vglarra/jaiba-monitor-support-frame/mon2_11in6_v21_m4ends_base.stl

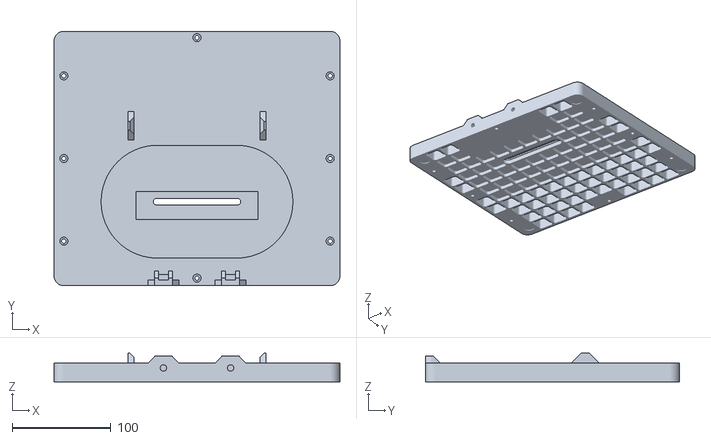
[picture p1: CAD file, 2026-11-12]
mon2_11in6_v21_m4ends_base.stl
290.0 x 258.0 x 29.0
