vglarra/jaiba-monitor-support-frame/mon1_7in_v19_leftrib_beside_turntable.stl

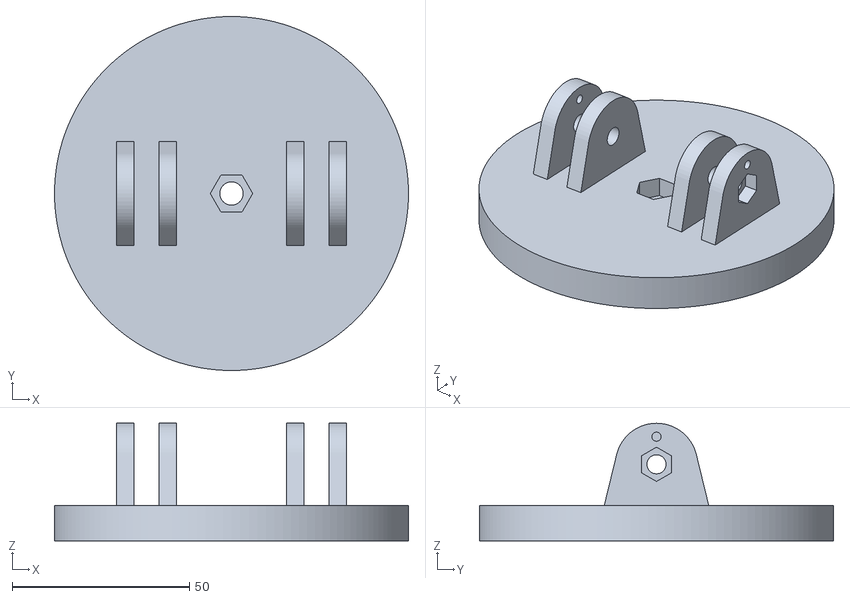
[picture p2: CAD file, 2026-11-08]
mon1_7in_v19_leftrib_beside_turntable.stl
100.0 x 100.0 x 33.2
