vglarra/jaiba-monitor-support-frame/mon1_7in_v19_leftrib_beside_lid.stl

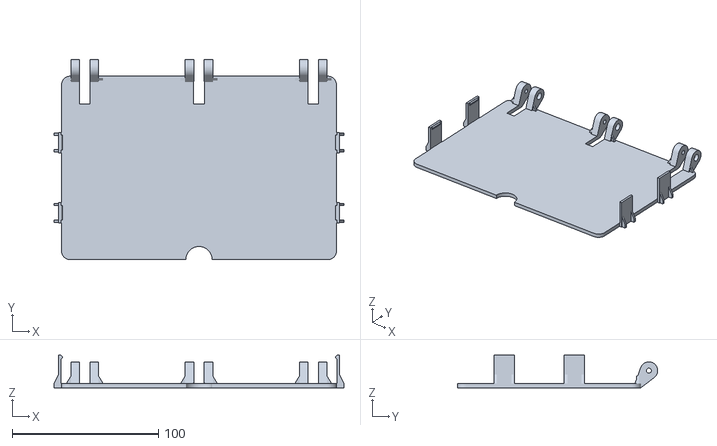
[picture p3: CAD file, 2026-11-08]
mon1_7in_v19_leftrib_beside_lid.stl
198.0 x 136.8 x 22.2
