vglarra/jaiba-monitor-support-frame/mon1_7in_v19_leftrib_beside_frame.stl

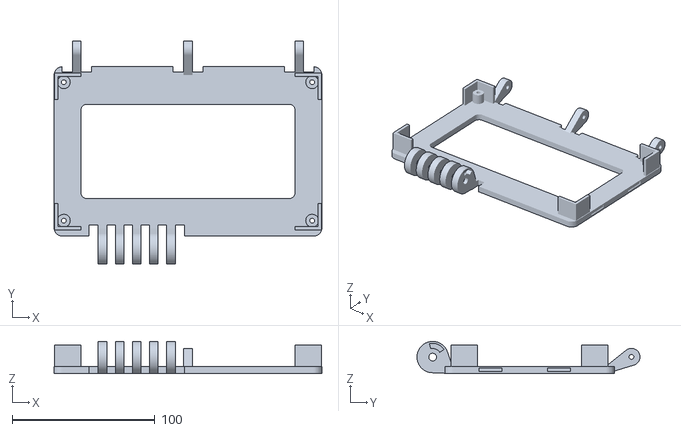
[picture p4: CAD file, 2026-11-08]
mon1_7in_v19_leftrib_beside_frame.stl
187.8 x 156.3 x 22.6
