vglarra/jaiba-monitor-support-frame/mon1_7in_v19_leftrib_beside_base.stl

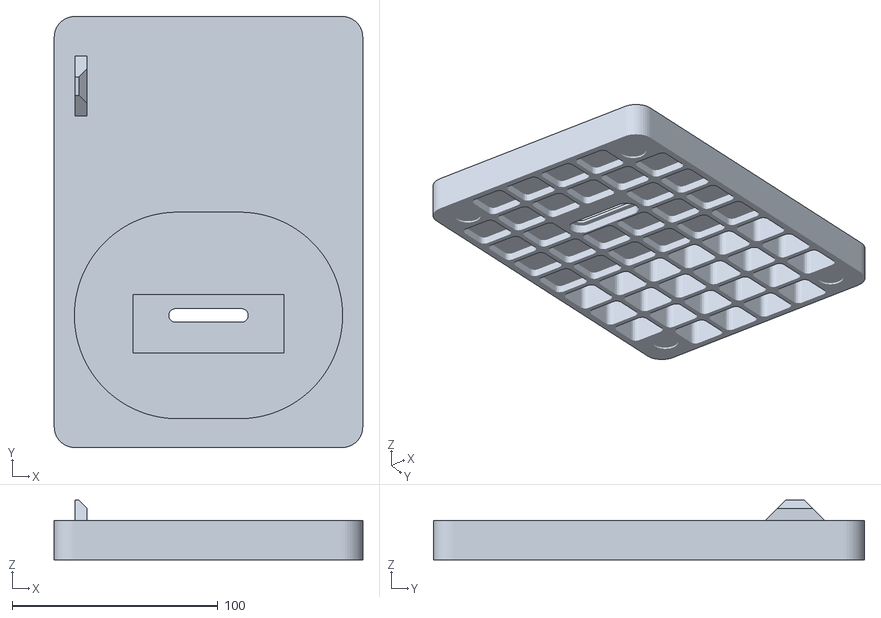
[picture p5: CAD file, 2026-11-08]
mon1_7in_v19_leftrib_beside_base.stl
150.0 x 209.5 x 29.0
