vglarra/jaiba-monitor-support-frame/mon1_7in_v19_leftrib_beside_spacer.stl

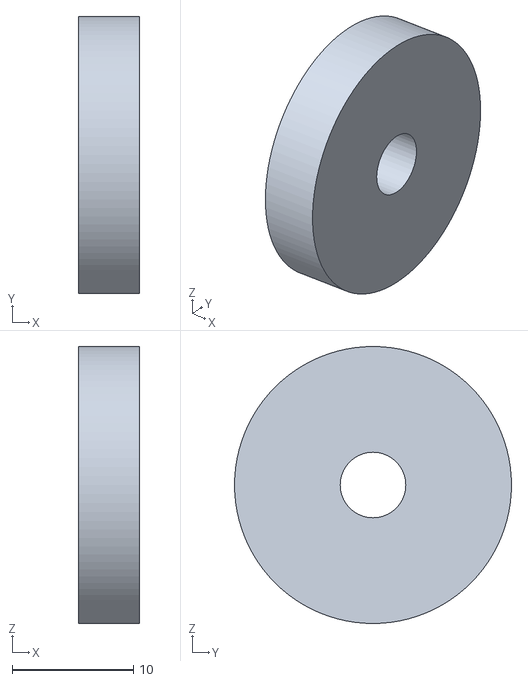
[picture p6: CAD file, 2026-11-08]
mon1_7in_v19_leftrib_beside_spacer.stl
5.00 x 22.8 x 22.8
