vglarra/jaiba-monitor-support-frame/mon1_7in_v19_leftrib_beside_carriage.stl

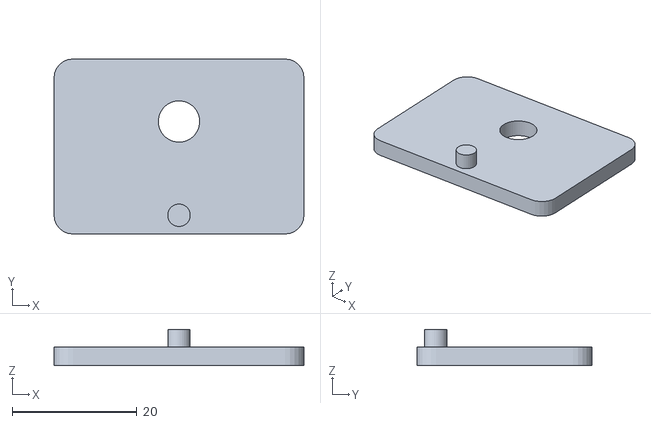
[picture p7: CAD file, 2026-11-08]
mon1_7in_v19_leftrib_beside_carriage.stl
40.0 x 28.0 x 5.80
