vglarra/jaiba-monitor-support-frame/(list of files, cad)

Other CAD files:
mon1_7in_v19_leftrib_beside_assembly.blend
mon2_11in6_v21_m4ends_assembly.blend
