vglarra/jaiba-monitor-support-frame/(commit log)

2026-11-08 Initial commit: parametric monitor stand generator and STL variants
    Add Blender scripts for the 7in PCB-monitor stand (make_stand.py) and 11.6in VESA monitor stand (make_stand_mon2.py, and the spacer variant). Include export STLs and assembly .blend files for v14, v15 and v16 designs, plus README.
    [mon2_11in6_v14_m6swivel_assembly.blend, mon2_11in6_v14_m6swivel_base.stl, mon2_11in6_v14_m6swivel_carriage.stl, mon2_11in6_v14_m6swivel_frame.stl, mon2_11in6_v14_m6swivel_lockblock.stl, mon2_11in6_v14_m6swivel_turntable.stl, mon2_11in6_v15_spacer_assembly.blend, mon2_11in6_v15_spacer_base.stl]
2026-11-08 Keep only the latest design of each stand; drop old versions
    Remove mon2 v14/v15/v16 outputs and mon1 v15-v18 outputs. Keep mon1 v19 (leftrib_beside) via make_stand.py and mon2 v18 (seatribs) via make_stand_mon2.py. Remove the duplicated 'make_stand_mon2 (1).py' copy.
    [mon1_7in_v19_leftrib_beside_assembly.blend, mon1_7in_v19_leftrib_beside_base.stl, mon1_7in_v19_leftrib_beside_carriage.stl, mon1_7in_v19_leftrib_beside_frame.stl, mon1_7in_v19_leftrib_beside_lid.stl, mon1_7in_v19_leftrib_beside_spacer.stl, mon1_7in_v19_leftrib_beside_turntable.stl, mon2_11in6_v14_m6swivel_assembly.blend]
2026-11-12 Bump mon2 to v21 (m4ends); drop v18-v20 outputs
    Keep only the latest mon2 design (v21 m4ends) alongside mon1 v19. Remove mon2 v18/v19/v20 STLs and blends, drop the duplicate make_stand_mon2 (1).py, and ignore __pycache__/previews.
    [mon2_11in6_v18_seatribs_assembly.blend, mon2_11in6_v18_seatribs_base.stl, mon2_11in6_v18_seatribs_carriage.stl, mon2_11in6_v18_seatribs_frame.stl, mon2_11in6_v18_seatribs_lockblock.stl, mon2_11in6_v18_seatribs_spacer.stl, mon2_11in6_v18_seatribs_turntable.stl, mon2_11in6_v21_m4ends_assembly.blend]
